KatsuhiroMorishita/Wireless-LED-control/circuit designed with Eagle/archive/readme.txt

注意事項をいかに示す。

１）本フォルダ内のファイルは最新版とは限りません。
２）回路パターンはCNC加工を前提に設計しています。
　そのままでは外部発注できません。
