KatsuhiroMorishita/Wireless-LED-control/program/type02/不採用となった電子回路モデル.pptx

## 電子回路モデル

2014-05-30
Katsuhiro MORISHITA

## 装置の概要図

キリ穴加工済みの竹筒　合計31本

石垣

ステージ奥の台

ステージ

## LEDの設置方法

断面

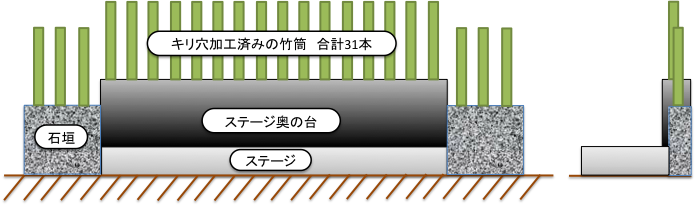
[picture p1: figure]

LANケーブル

## 制御のグルーピング

- 制御IOポートの削減
- 電源装置のスリム化
