KatsuhiroMorishita/Wireless-LED-control/circuit designed with Eagle/CNC加工条件/加工条件.png

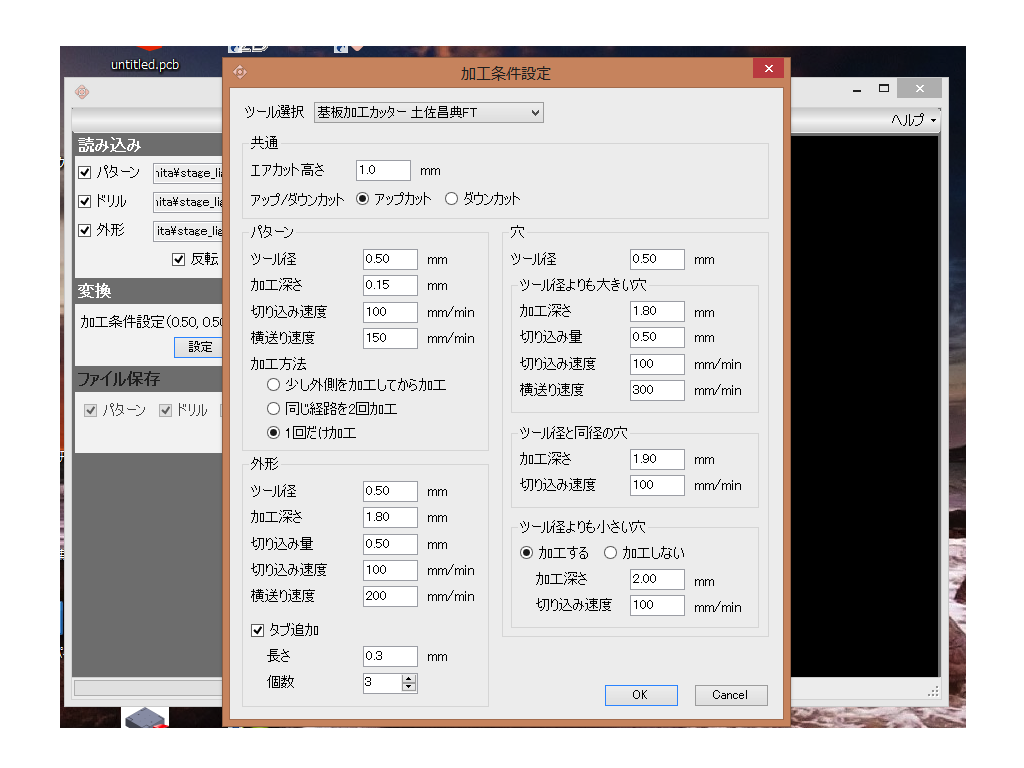
circuit designed with Eagle/CNC加工条件/加工条件.png
