KatsuhiroMorishita/Wireless-LED-control/program/type02/type02_firmware/利用可能なブートローダ.png

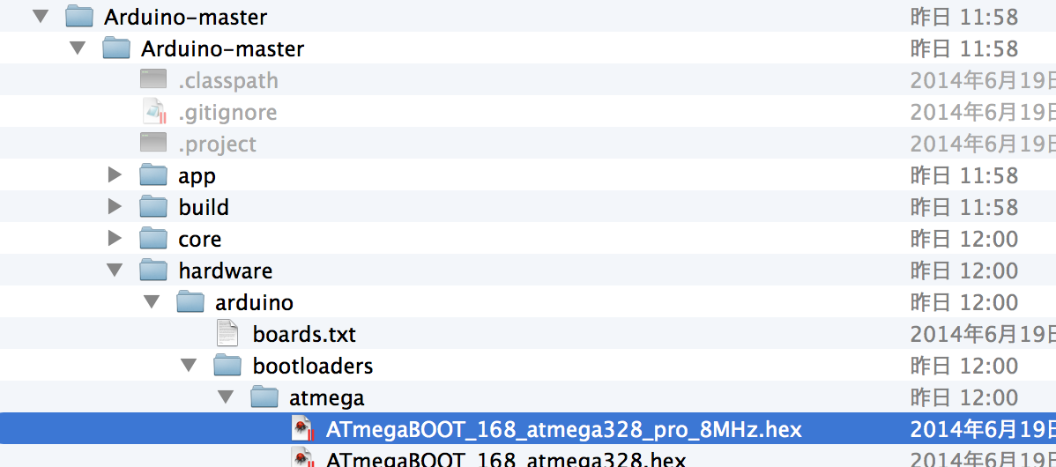
program/type02/type02_firmware/利用可能なブートローダ.png
