KatsuhiroMorishita/Wireless-LED-control/program/controler/order_switch/設計.pptx

Ch 0x0C

XBee
S1

XBee
S1

XBee
S1

Ch 0x14

XBee
S1

XBee
S1

XBee
S1

XBee
S1

XBee
S1

XBee
S1

XBee
S1

XBee
S1

XBee
S1

USBシリアル
最低、11200 kbps

XBee
S1

XBee
S1

Ch 0x0F

XBee
S1

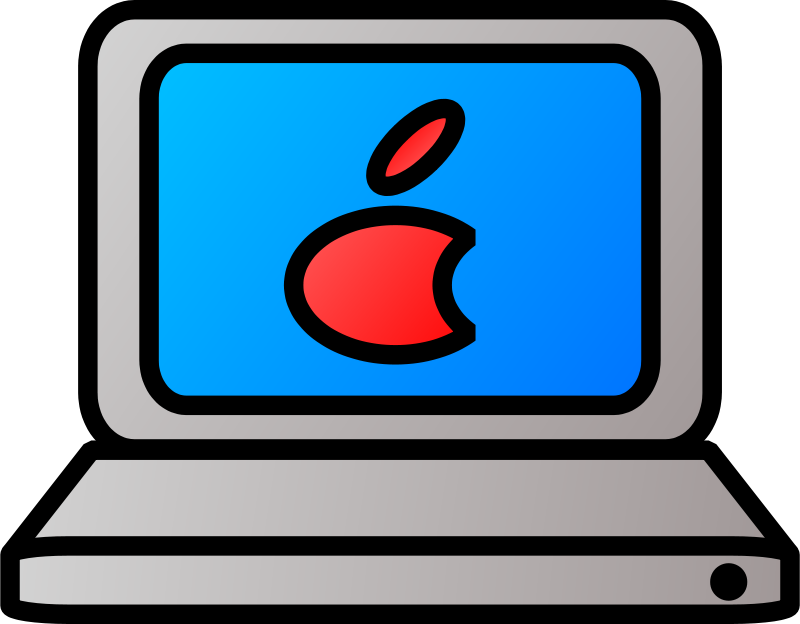
[picture p4: figure]
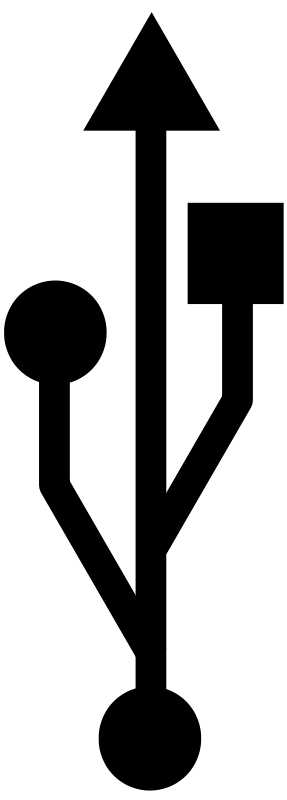
[picture p5: figure]
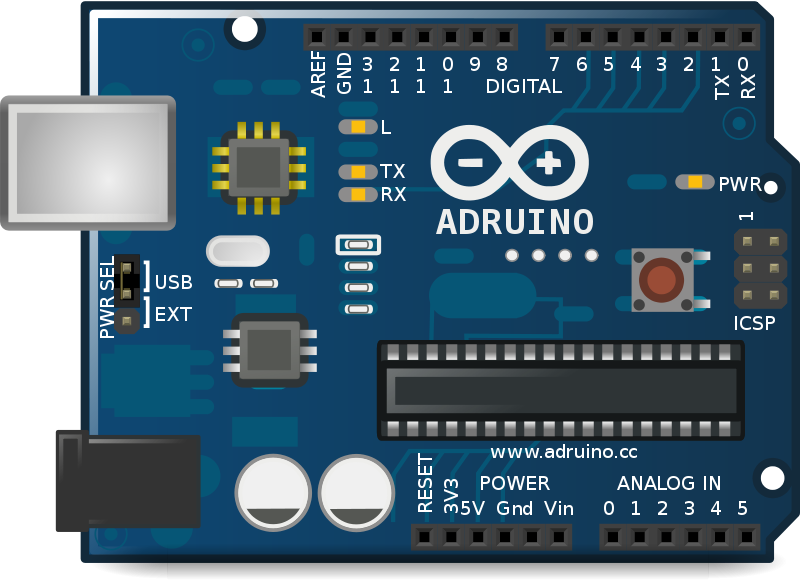
[picture p6: figure]

Arduino mega
（絵はUNO）

本スケッチの
実装対象

Arduino mega
（絵はUNO）
