KatsuhiroMorishita/Wireless-LED-control/program/type01/old/v1/test_data/test data.xlsx

Sheet: Sheet1
bias | 128
amplitude | 126
frequency [Hz] | 0.5
time step [s] | 0.1
 | red | green | blue
offset | 0 | 1.047197551 | 2.094395102
0 | 128 | 237 | 237
1 | 166 | 251 | 212
2 | 202 | 253 | 179
3 | 229 | 243 | 141
4 | 247 | 221 | 101
5 | 254 | 191 | 65
6 | 247 | 154 | 34
7 | 229 | 114 | 12
8 | 202 | 76 | 2
9 | 166 | 43 | 4
10 | 128 | 18 | 18
11 | 89 | 4 | 43
12 | 53 | 2 | 76
13 | 26 | 12 | 114
14 | 8 | 34 | 154
15 | 2 | 64 | 191
16 | 8 | 101 | 221
17 | 26 | 141 | 243
18 | 53 | 179 | 253
19 | 89 | 212 | 251
20 | 128 | 237 | 237
21 | 166 | 251 | 212
22 | 202 | 253 | 179
23 | 229 | 243 | 141
24 | 247 | 221 | 101
25 | 254 | 191 | 64
26 | 247 | 154 | 34
27 | 229 | 114 | 12
28 | 202 | 76 | 2
29 | 166 | 43 | 4
30 | 128 | 18 | 18
31 | 89 | 4 | 43
32 | 53 | 2 | 76
33 | 26 | 12 | 114
34 | 8 | 34 | 154
35 | 2 | 65 | 191
36 | 8 | 101 | 221
37 | 26 | 141 | 243
38 | 53 | 179 | 253
39 | 89 | 212 | 251
40 | 128 | 237 | 237
41 | 166 | 251 | 212
42 | 202 | 253 | 179
43 | 229 | 243 | 141
44 | 247 | 221 | 101
45 | 254 | 191 | 64
46 | 247 | 154 | 34
47 | 229 | 114 | 12
48 | 202 | 76 | 2
49 | 166 | 43 | 4
50 | 128 | 18 | 18
51 | 89 | 4 | 43
52 | 53 | 2 | 76
53 | 26 | 12 | 114
54 | 8 | 34 | 154
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
