KatsuhiroMorishita/Wireless-LED-control/circuit designed with Eagle/stage_light_control/stage_light_control.brd

## EAGLE design circuit designed with Eagle/stage_light_control/stage_light_control.brd (2014-06-23)

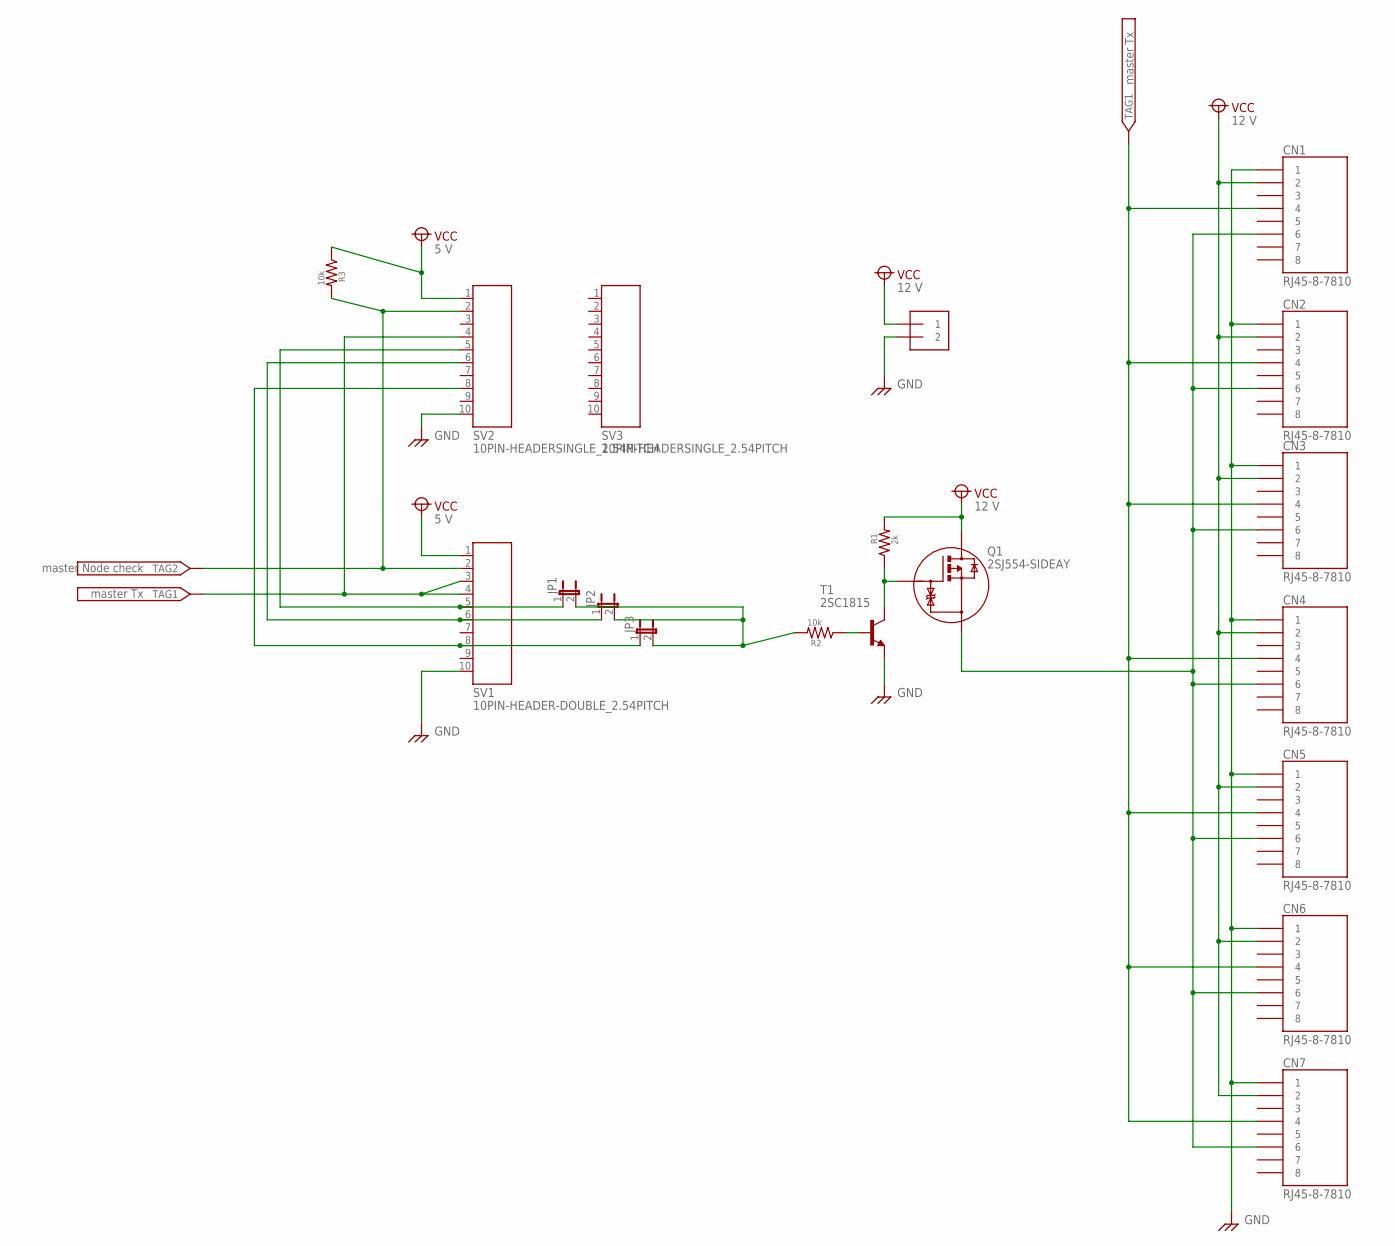
[picture p7: schematic stage_light_control.sch]

Parts:
CN1, CN2, CN3, CN4, CN5, CN6, CN7: RJ45-8-7810; RJ-45_7810-8P8C
J1: 1X2-7.5MM
JP1, JP2, JP3: JUMPER-2PTH; 1X02
Q1: 2SJ554-SIDEAY; TO-3P
R1: 2k; 1608(1.6*0.8MM)
R2, R3: 10k; 1608(1.6*0.8MM)
SV1: 10PIN-HEADER-DOUBLE_2.54PITCH; 2*5(2.54PITCH)
SV2, SV3: 10PIN-HEADERSINGLE_2.54PITCH; 1*10(2.54PITCH)
T1: 2SC1815; TO92-ECB

Connections:
GND: CN1.1, CN2.1, CN3.1, CN4.1, CN5.1, CN6.1, CN7.1, J1.P$2 (2), SV1.10, SV2.10, T1.E
unnamed: Q1.1, R1.P$3 (1), T1.C
unnamed: R2.P$3 (1), T1.B
unnamed: JP1.1, SV1.5, SV2.5
unnamed: JP2.1, SV1.6, SV2.6
unnamed: JP3.1, SV1.8, SV2.8
unnamed: CN1.6, CN2.6, CN3.6, CN4.6, CN5.6, CN6.6, CN7.6, Q1.2
unnamed: JP1.2, JP2.2, JP3.2, R2.P$4 (2)
TAG1: CN1.4, CN2.4, CN3.4, CN4.4, CN5.4, CN6.4, CN7.4, SV1.3, SV1.4, SV2.4
TAG2: R3.P$4 (2), SV1.2, SV2.2
VCC1: R3.P$3 (1), SV1.1, SV2.1
VCC2: CN1.2, CN2.2, CN3.2, CN4.2, CN5.2, CN6.2, CN7.2, J1.P$1 (1), Q1.3, R1.P$4 (2)

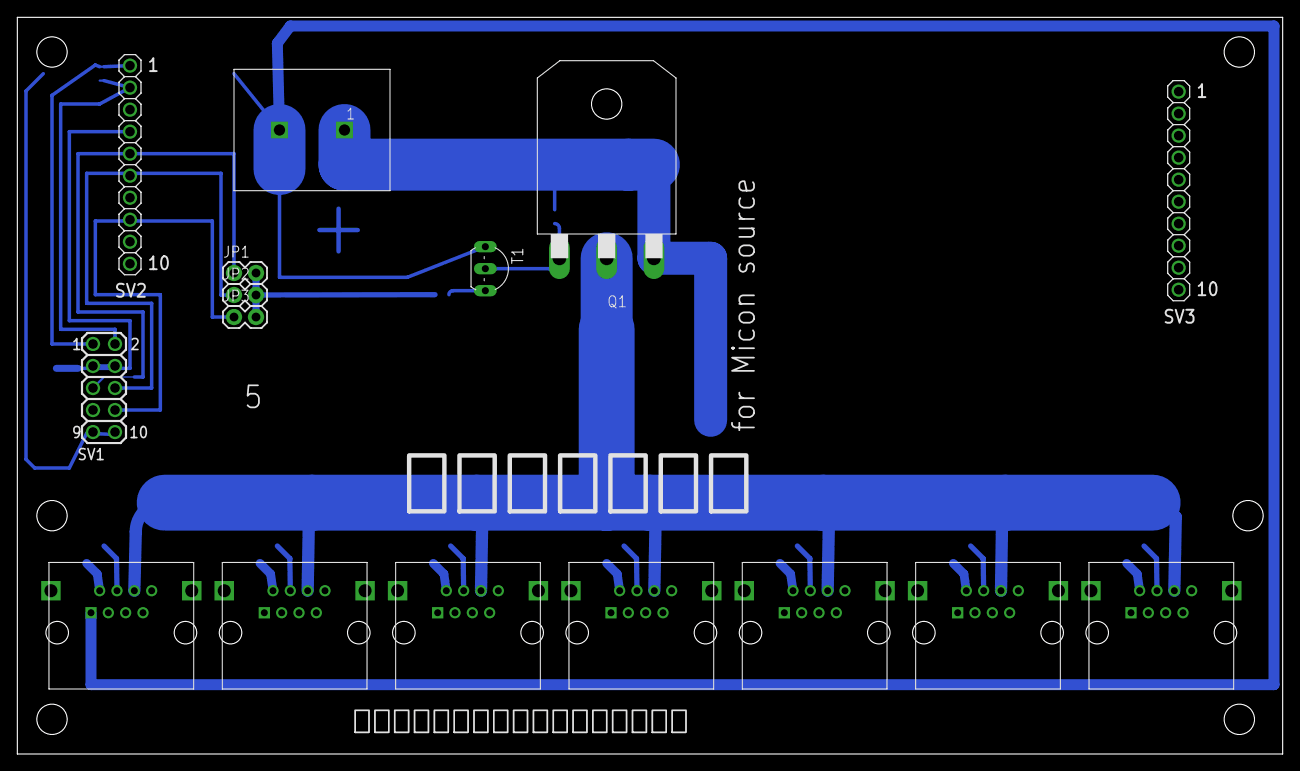
[picture p8: board stage_light_control.brd from above]

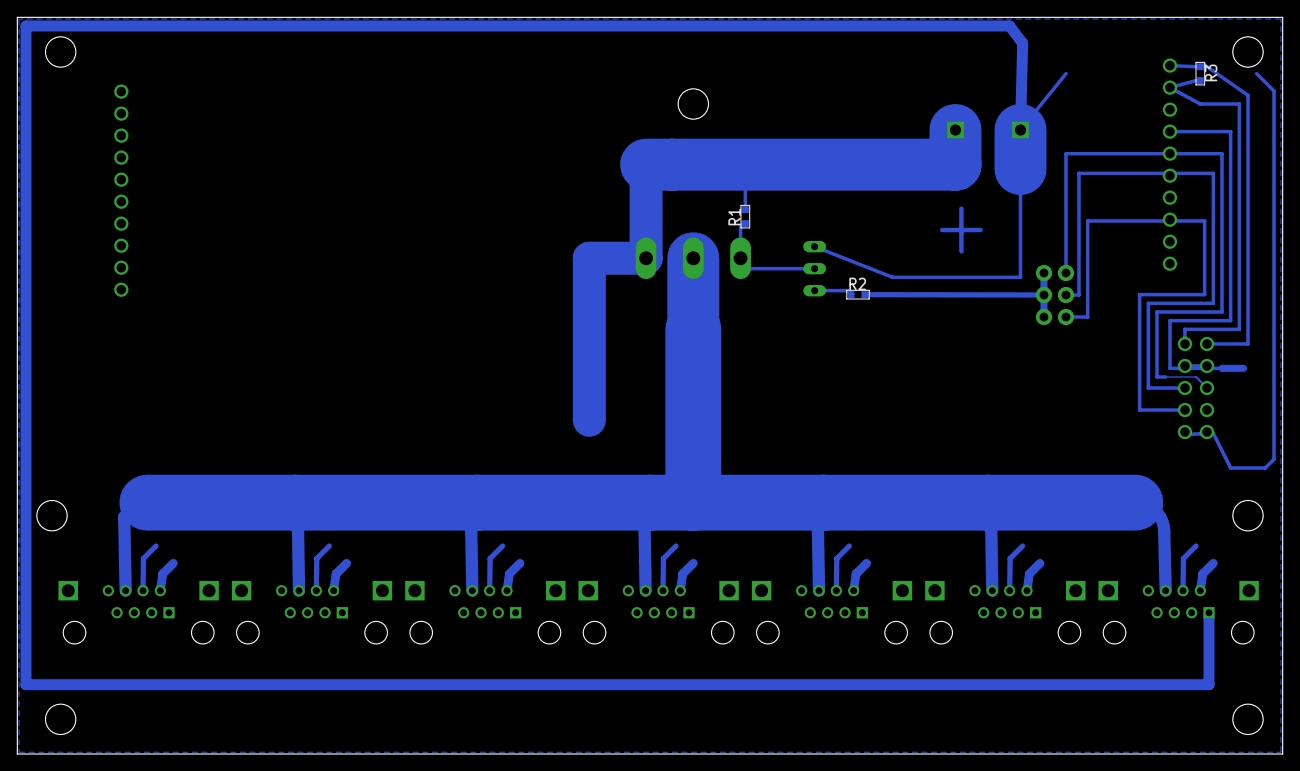
[picture p9: board stage_light_control.brd from below]

Board: 2 copper layers, 146.0 x 85.0 mm, 19 parts (3 on the bottom side), 12 nets.
