KatsuhiroMorishita/Wireless-LED-control/circuit designed with Eagle/take_light_table/table_light_shield.brd

## EAGLE design circuit designed with Eagle/take_light_table/table_light_shield.brd (2014-06-23)

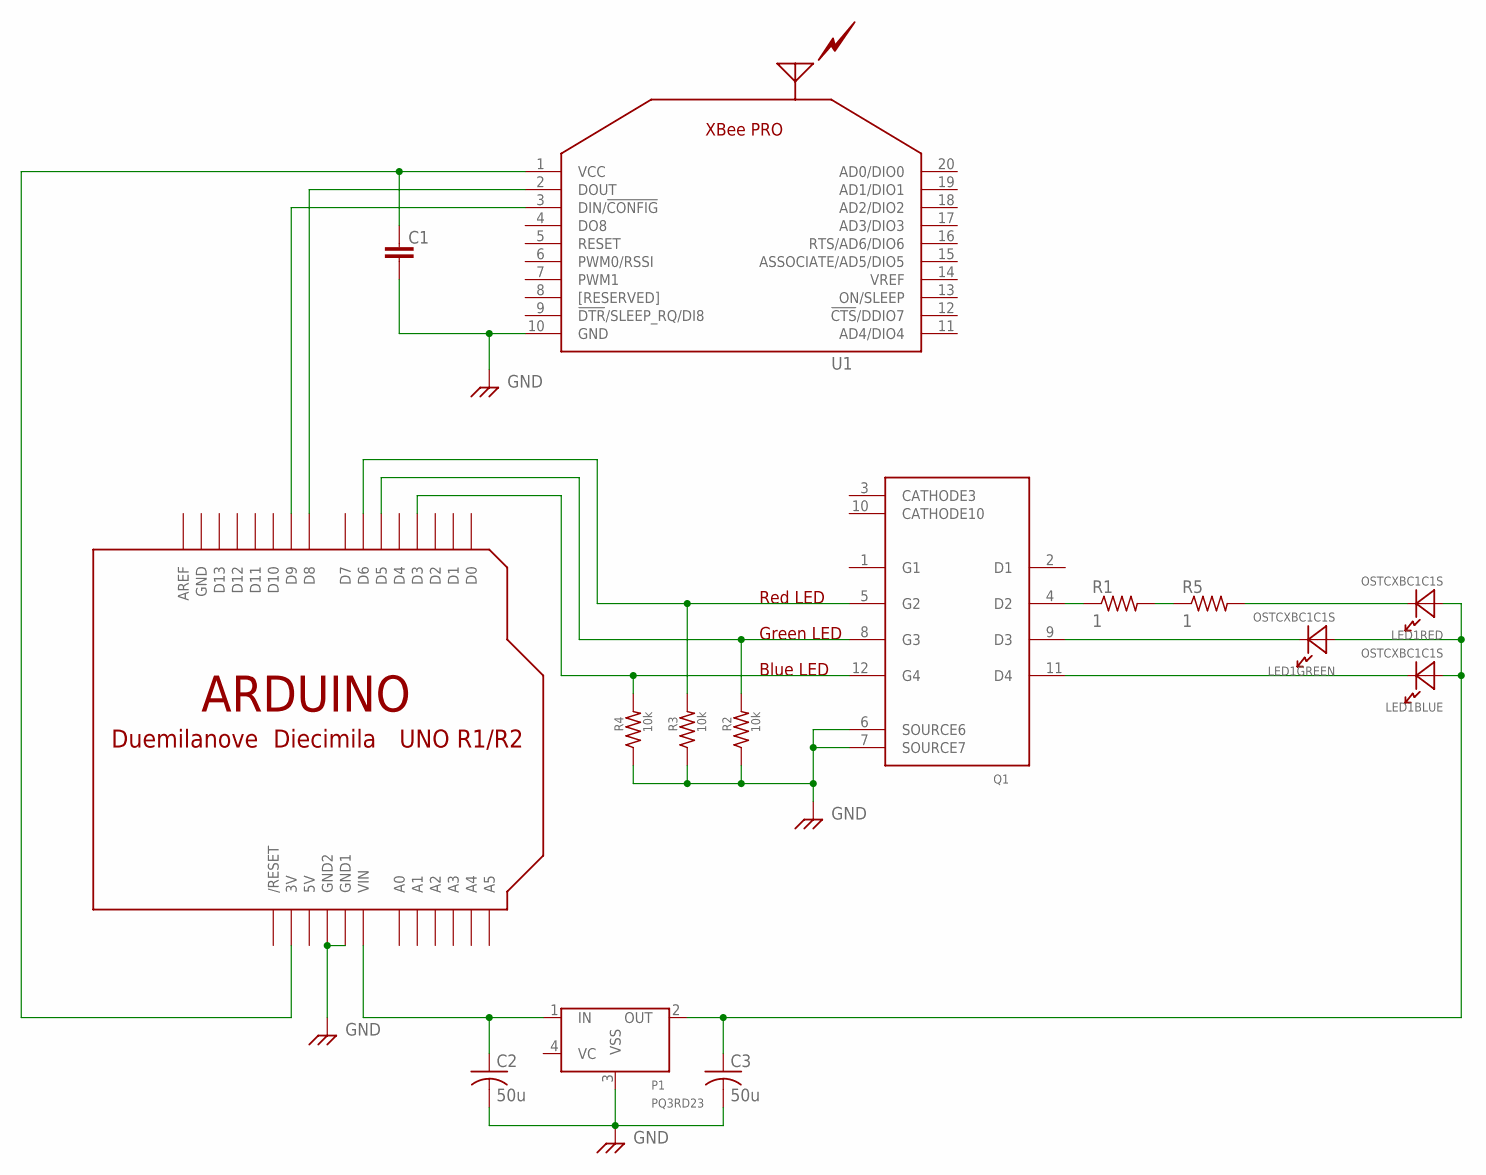
[picture p10: schematic table_light_shield.sch]

Parts:
C1: GRM18; 1608(1.6*0.8MM)
C2, C3: 50u; C025-050X050
LED1: OSTCXBC1C1S; OSTCXBC1C1S_WITH_HEATSINK
P1: PQ3RD23
Q1: MP4401
R1, R5: 1; 0805-THM
R2, R3, R4: 10k; 1608(1.6*0.8MM)
U1: XBEE_PROXPPN101BFCN; XBEE_ON_XPPN101BFCN-RC
U$1: ARDUINO-NOHOLE

Connections:
5V: U$1.5V
GND: C1.P$2 (2), C2.2, C3.2, P1.3 (VSS), Q1.6 (SOURCE6), Q1.7 (SOURCE7), R2.P$3 (1), R3.P$3 (1), R4.P$3 (1), U1.10 (GND), U$1.GND, U$1.GND1, U$1.GND2
unnamed: C2.1, P1.1 (IN), U$1.VIN
unnamed: Q1.4 (D2), R1.1
unnamed: Q1.5 (G2), R3.P$4 (2), U$1.D6
unnamed: Q1.8 (G3), R2.P$4 (2), U$1.D5
unnamed: Q1.12 (G4), R4.P$4 (2), U$1.D3
unnamed: C1.P$1 (1), U1.1 (VCC), U$1.3V
unnamed: U1.2 (DOUT), U$1.D8
unnamed: U1.3 (DIN/!CONFIG), U$1.D9
unnamed: LED1.B- (C), Q1.11 (D4)
unnamed: LED1.R- (C), R5.2
unnamed: R1.2, R5.1
unnamed: C3.1, LED1.B+ (A), LED1.G+ (A), LED1.R+ (A), P1.2 (OUT)
unnamed: LED1.G- (C), Q1.9 (D3)

Notes on the sheet:
Red LED
Green LED
Blue LED

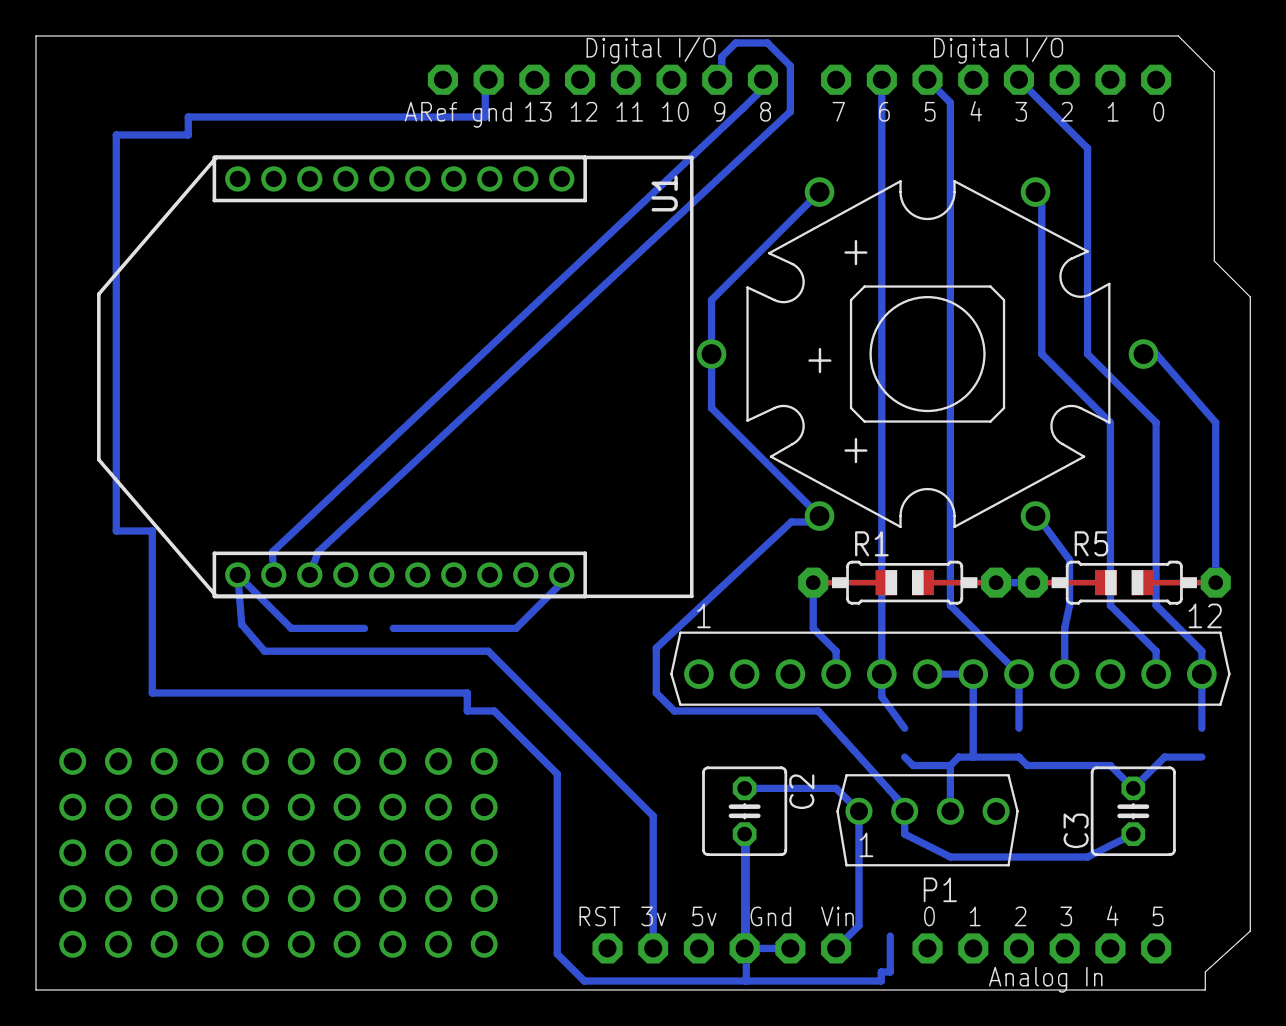
[picture p11: board table_light_shield.brd from above]

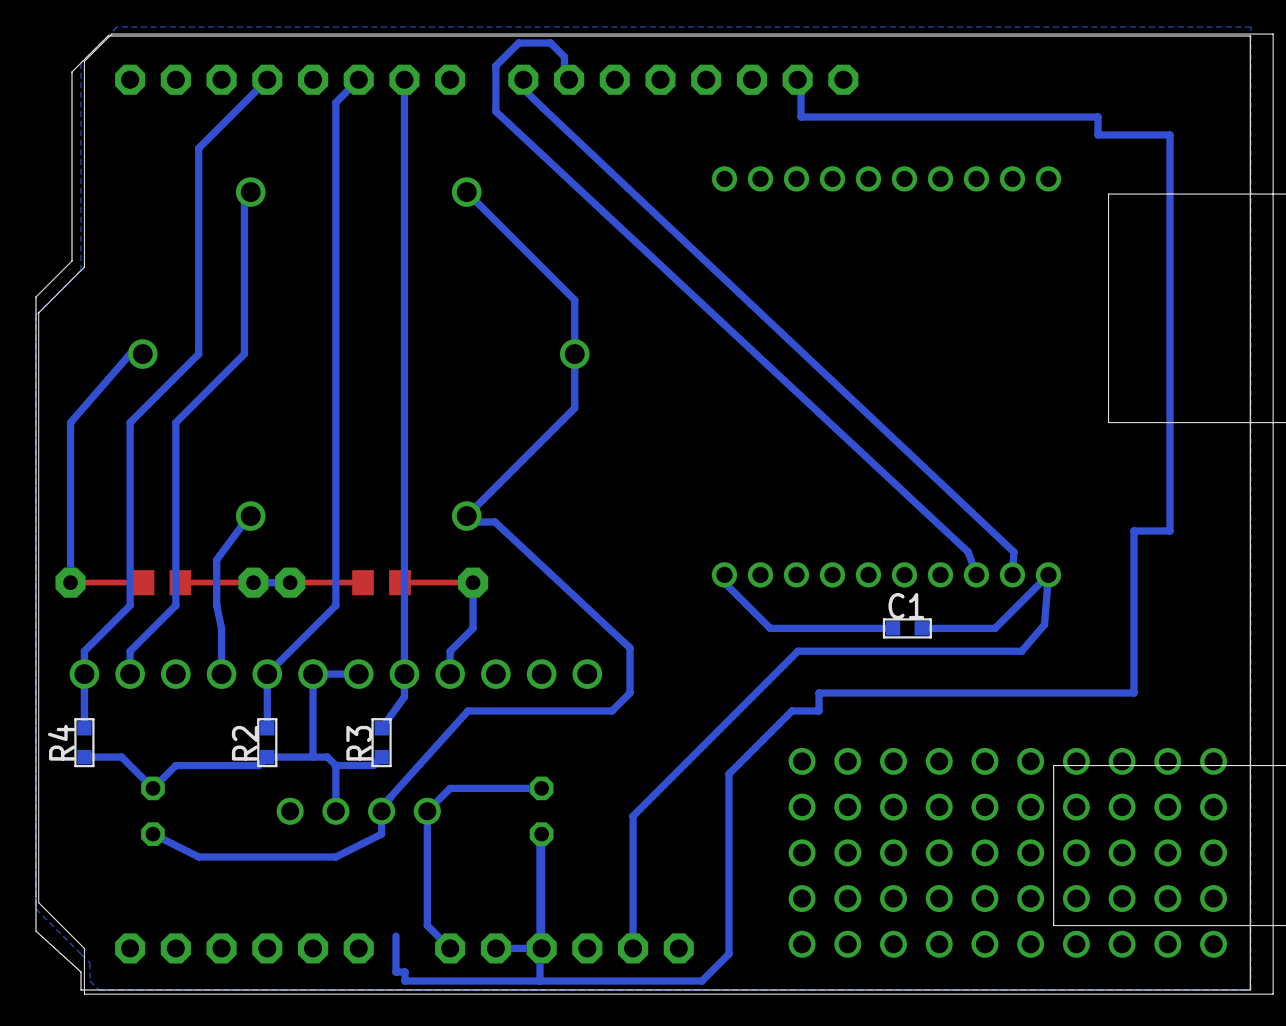
[picture p12: board table_light_shield.brd from below]

Board: 2 copper layers, 67.5 x 53.0 mm, 13 parts (4 on the bottom side), 14 nets.
