KatsuhiroMorishita/Wireless-LED-control/circuit designed with Eagle/stage_light/stage_light.brd

## EAGLE design circuit designed with Eagle/stage_light/stage_light.brd (2014-06-23)

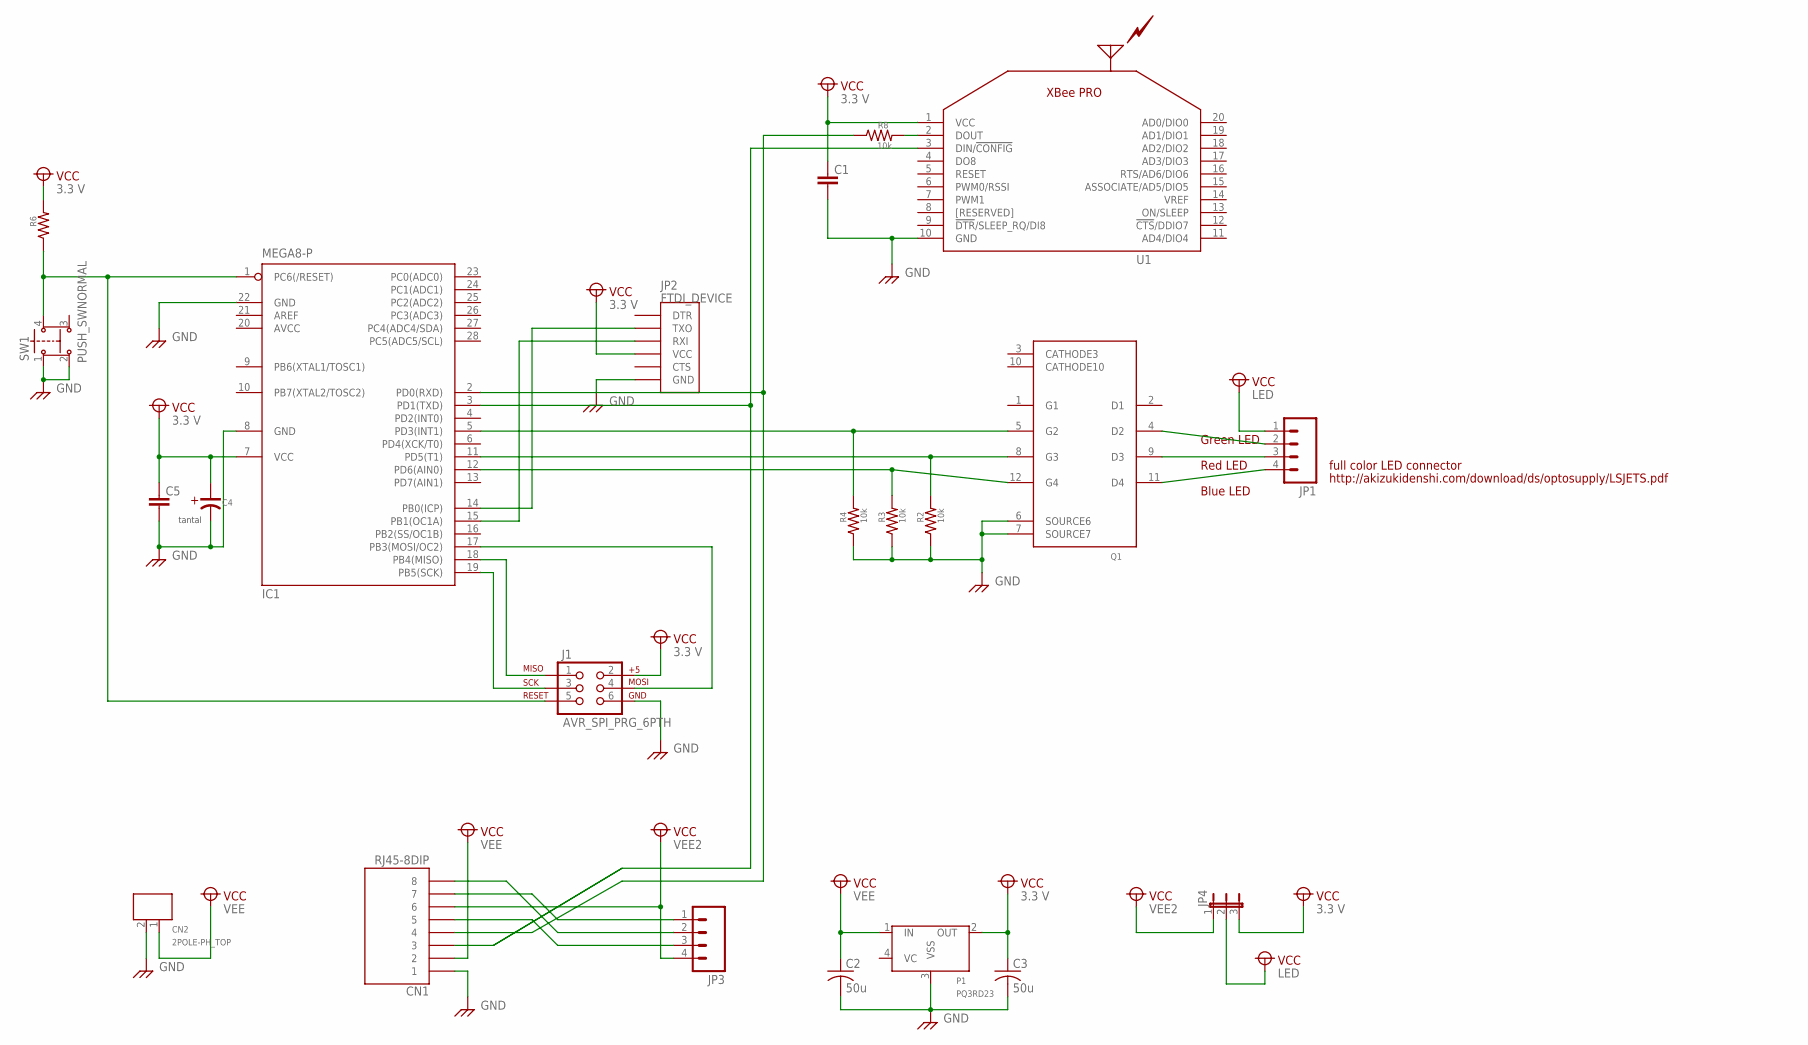
[picture p13: schematic stage_light.sch]

Parts:
C1, C5: GRM18; 1608(1.6*0.8MM)
C2, C3: 50u; C025-050X050
C4: CT-100U; 6134(6.1*3.4MM)_POLAR
CN1: RJ45-8DIP; AE-RJ-45-LAN-DIP-A
CN2: 2POLE-PH_TOP; B2B-PH-K-S(2MM_PITCH)
IC1: MEGA8-P; DIL28-3
J1: AVR_SPI_PRG_6PTH; 2X3
JP1: M04LONGPADS; 1X04_LONGPADS
JP2: FTDI_DEVICE; FTDI_DEVICE_SIDE
JP3: M04PTH; 1X04
JP4: JP2E; JP2
P1: PQ3RD23
Q1: MP4401
R2, R3, R4, R8: 10k; 1608(1.6*0.8MM)
R6: CHIP1608; 1608(1.6*0.8MM)
SW1: PUSH_SWNORMAL; PUSH_SW
U1: XBEE_PROXPPN101BFCN; XBEE_ON_XPPN101BFCN-RC

Connections:
AVCC: IC1.20 (AVCC)
GND: C1.P$2 (2), C2.2, C3.2, C4.-, C5.P$2 (2), CN1.1, CN2.2, IC1.8 (GND), IC1.22 (GND), J1.6, JP2.P$6 (GND), P1.3 (VSS), Q1.6 (SOURCE6), Q1.7 (SOURCE7), R2.P$3 (1), R3.P$3 (1), R4.P$3 (1), SW1.1, SW1.2, U1.10 (GND)
unnamed: JP1.3, Q1.9 (D3)
unnamed: JP1.2, Q1.4 (D2)
unnamed: IC1.12 (PD6(AIN0)), Q1.12 (G4), R3.P$4 (2)
unnamed: IC1.11 (PD5(T1)), Q1.8 (G3), R2.P$4 (2)
unnamed: IC1.5 (PD3(INT1)), Q1.5 (G2), R4.P$4 (2)
unnamed: JP1.4, Q1.11 (D4)
unnamed: IC1.14 (PB0(ICP)), JP2.P$2 (TXO)
unnamed: IC1.15 (PB1(OC1A)), JP2.P$3 (RXI)
unnamed: CN1.8, JP3.2
unnamed: CN1.5, JP3.3
unnamed: CN1.7, JP3.1
unnamed: IC1.1 (PC6(/RESET)), J1.5, R6.P$3 (1), SW1.4 (P3)
unnamed: R8.P$4 (2), U1.2 (DOUT)
unnamed: CN1.4, IC1.2 (PD0(RXD)), R8.P$3 (1)
unnamed: CN1.3, IC1.3 (PD1(TXD)), U1.3 (DIN/!CONFIG)
unnamed: IC1.18 (PB4(MISO)), J1.1
unnamed: IC1.19 (PB5(SCK)), J1.3
unnamed: IC1.17 (PB3(MOSI/OC2)), J1.4
VCC1: C2.1, CN1.2, CN2.1, P1.1 (IN)
VCC2: C1.P$1 (1), C3.1, C4.+, C5.P$1 (1), IC1.7 (VCC), J1.2, JP2.P$4 (VCC), JP4.3, P1.2 (OUT), R6.P$4 (2), U1.1 (VCC)
VCC3: JP1.1, JP4.2
VCC4: CN1.6, JP3.4, JP4.1

Notes on the sheet:
Red LED
Green LED
Blue LED
full color LED connector
http://akizukidenshi.com/download/ds/optosupply/LSJETS.pdf

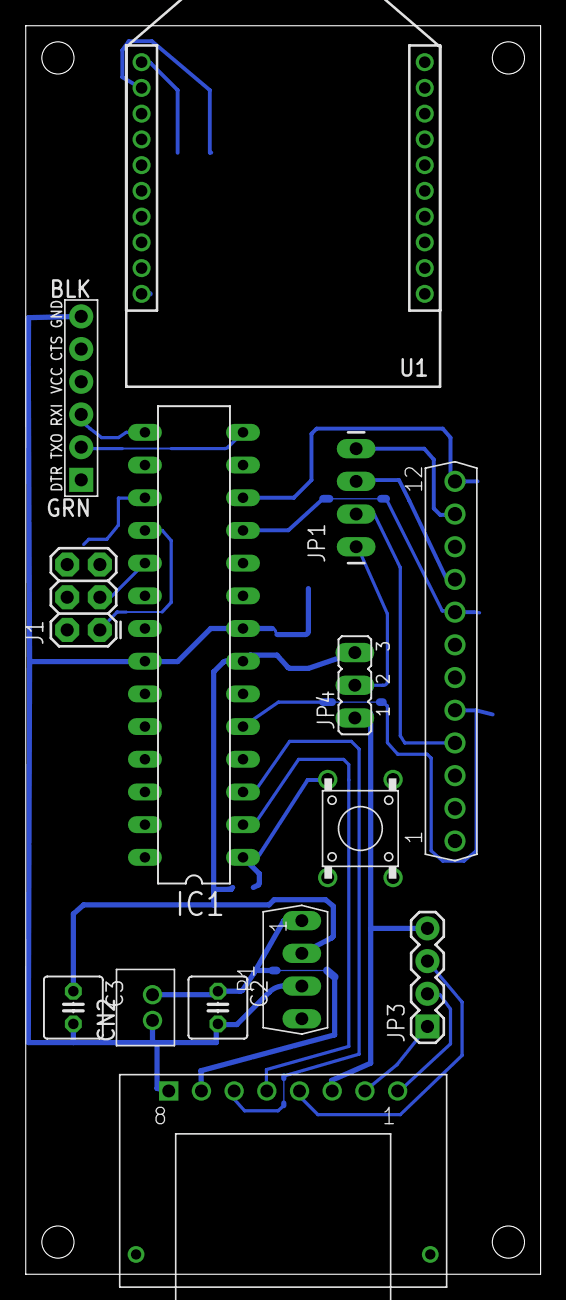
[picture p14: board stage_light.brd from above]

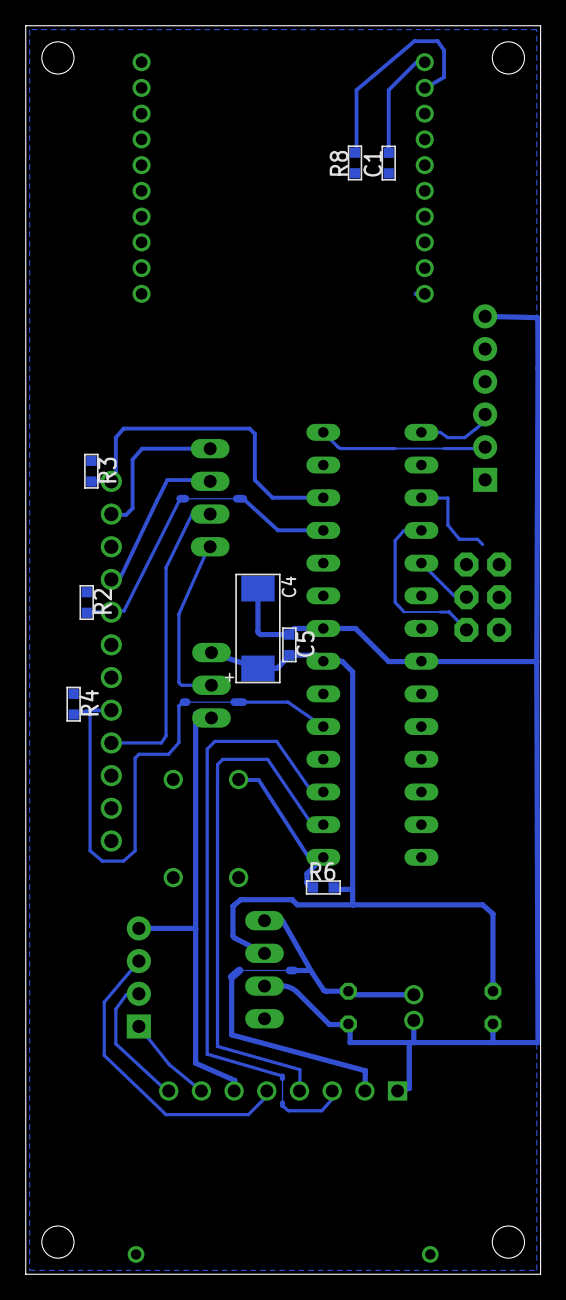
[picture p15: board stage_light.brd from below]

Board: 2 copper layers, 40.0 x 97.0 mm, 22 parts (8 on the bottom side), 23 nets.
