KatsuhiroMorishita/Wireless-LED-control/circuit designed with Eagle/stage_light_paste/stage_light_paste.brd

## EAGLE design circuit designed with Eagle/stage_light_paste/stage_light_paste.brd (2014-06-23)

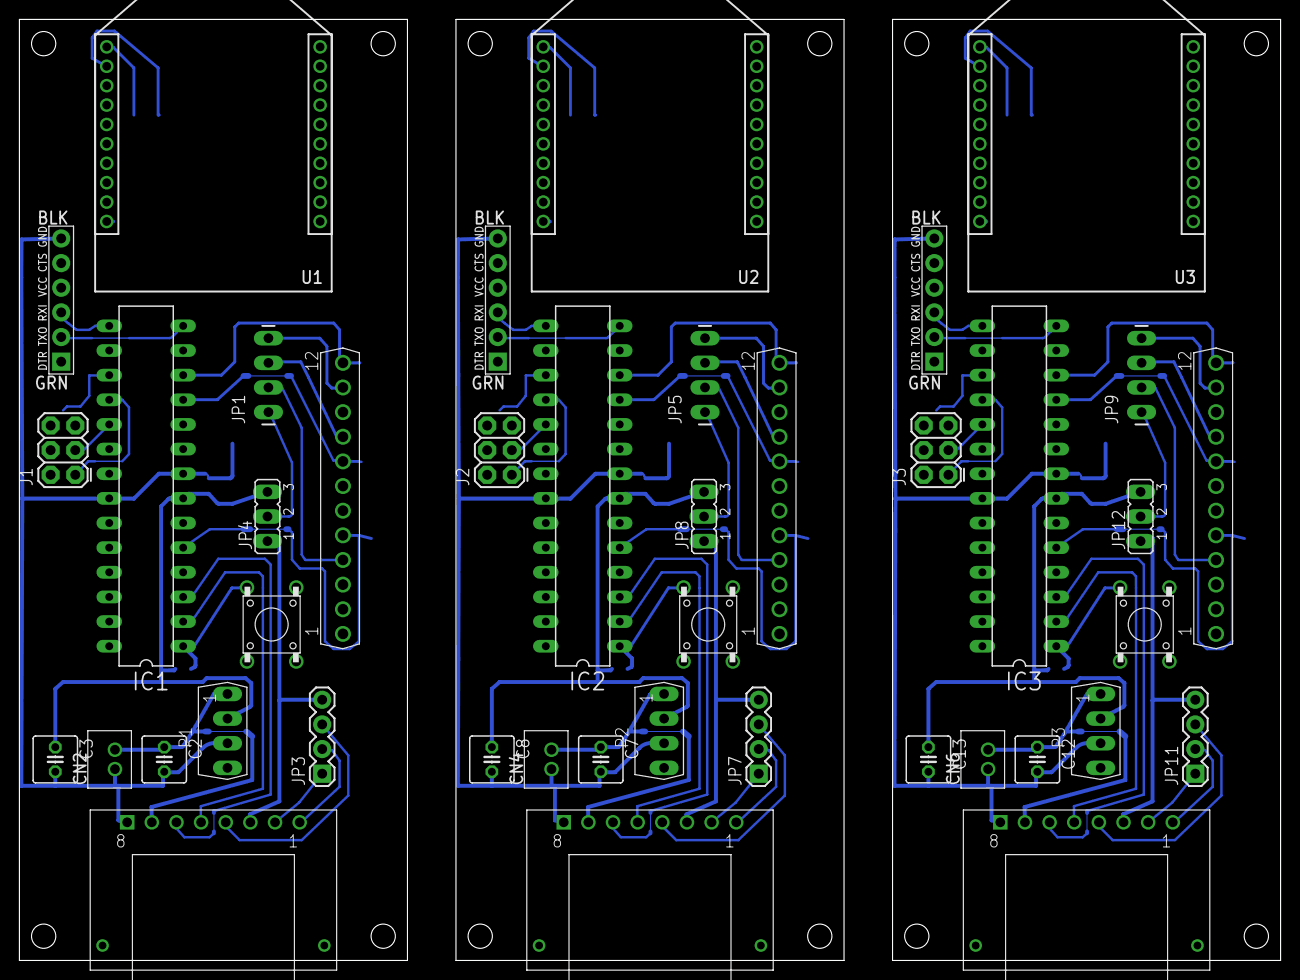
[picture p16: board stage_light_paste.brd from above]

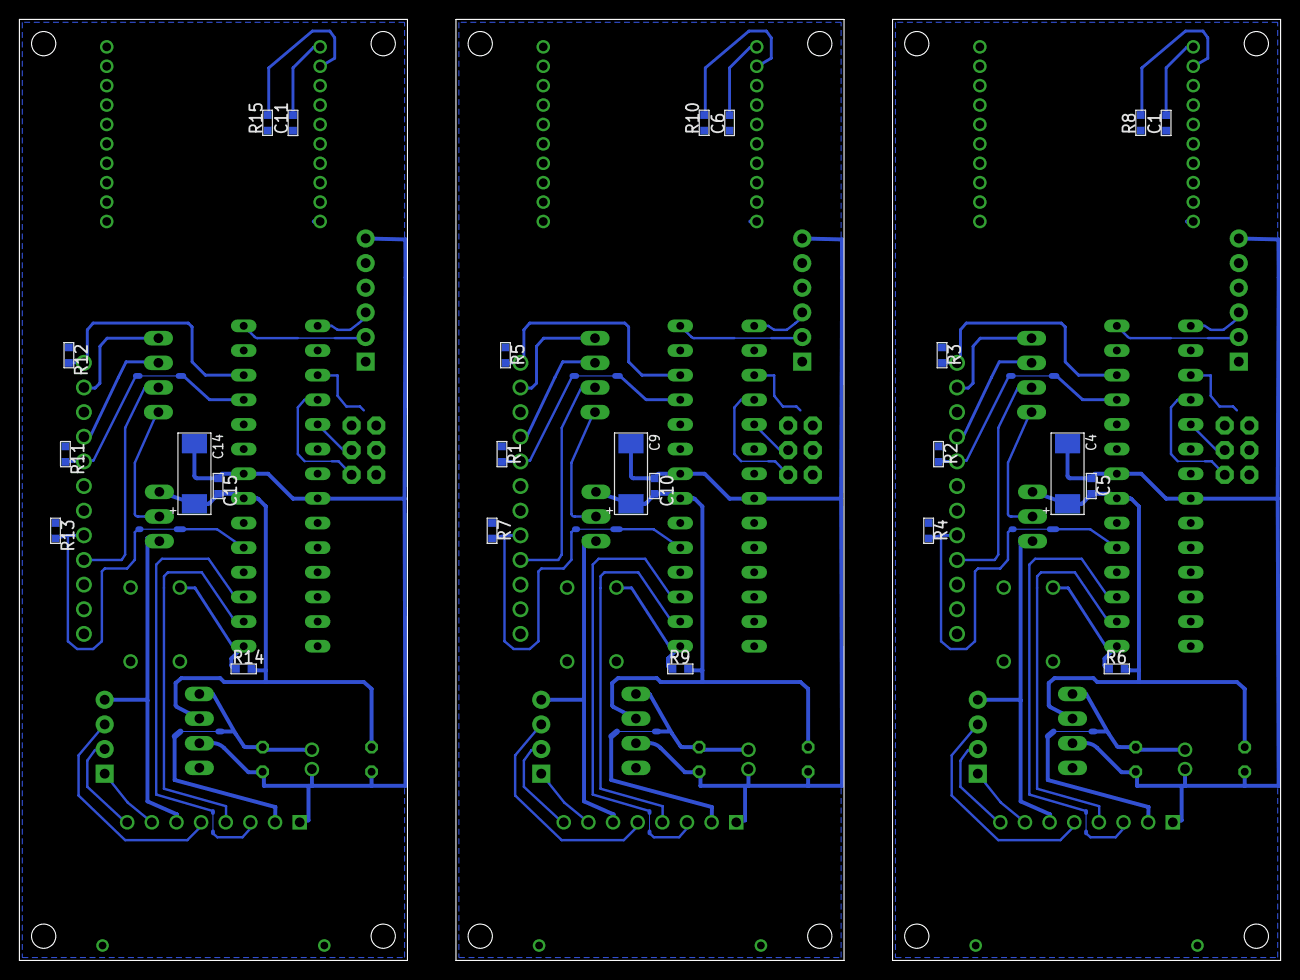
[picture p17: board stage_light_paste.brd from below]

Board: 2 copper layers, 130.0 x 97.0 mm, 66 parts (24 on the bottom side), 69 nets.

Parts:
C1, C5, C6, C10, C11, C15: 1608(1.6*0.8MM)
C2, C3, C7, C8, C12, C13: 50u; C025-050X050
C4, C9, C14: 6134(6.1*3.4MM)_POLAR
CN1, CN3, CN5: RJ45-8DIP; AE-RJ-45-LAN-DIP-A
CN2, CN4, CN6: 2POLE-PH_TOP; B2B-PH-K-S(2MM_PITCH)
IC1, IC2, IC3: MEGA8-P; DIL28-3
J1, J2, J3: AVR_SPI_PRG_6PTH; 2X3
JP1, JP5, JP9: 1X04_LONGPADS
JP2, JP6, JP10: FTDI_DEVICE; FTDI_DEVICE_SIDE
JP3, JP7, JP11: 1X04
JP4, JP8, JP12: JP2
P1, P2, P3: PQ3RD23
Q1, Q2, Q3: MP4401
R1, R2, R3, R4, R5, R7, R8, R10, R11, R12, R13, R15: 10k; 1608(1.6*0.8MM)
R6, R9, R14: 1608(1.6*0.8MM)
SW1, SW2, SW3: PUSH_SWNORMAL; PUSH_SW
U1, U2, U3: XBEE_PROXPPN101BFCN; XBEE_ON_XPPN101BFCN-RC

Connections:
GND: C1.P$2, C2.2, C3.2, C4.-, C5.P$2, CN1.1, CN2.2, IC1.8, IC1.22, J1.6, JP2.P$6, P1.3, Q1.6, Q1.7, R2.P$3, R3.P$3, R4.P$3, SW1.1, SW1.2, U1.10
GND1: C6.P$2, C7.2, C8.2, C9.-, C10.P$2, CN3.1, CN4.2, IC2.8, IC2.22, J2.6, JP6.P$6, P2.3, Q2.6, Q2.7, R1.P$3, R5.P$3, R7.P$3, SW2.1, SW2.2, U2.10
GND2: C11.P$2, C12.2, C13.2, C14.-, C15.P$2, CN5.1, CN6.2, IC3.8, IC3.22, J3.6, JP10.P$6, P3.3, Q3.6, Q3.7, R11.P$3, R12.P$3, R13.P$3, SW3.1, SW3.2, U3.10
unnamed: JP1.3, Q1.9
unnamed: JP1.2, Q1.4
unnamed: IC1.12, Q1.12, R3.P$4
unnamed: IC1.11, Q1.8, R2.P$4
unnamed: IC1.5, Q1.5, R4.P$4
unnamed: JP1.4, Q1.11
unnamed: IC1.14, JP2.P$2
unnamed: IC1.15, JP2.P$3
unnamed: CN1.8, JP3.2
unnamed: CN1.5, JP3.3
unnamed: CN1.7, JP3.1
unnamed: IC1.1, J1.5, R6.P$3, SW1.4
unnamed: R8.P$4, U1.2
unnamed: IC2.12, Q2.12, R5.P$4
unnamed: CN1.4, IC1.2, R8.P$3
unnamed: CN1.3, IC1.3, U1.3
unnamed: IC2.11, Q2.8, R1.P$4
unnamed: IC1.18, J1.1
unnamed: IC1.19, J1.3
unnamed: IC1.17, J1.4
unnamed: IC2.5, Q2.5, R7.P$4
unnamed: IC2.1, J2.5, R9.P$3, SW2.4
unnamed: CN3.4, IC2.2, R10.P$3
unnamed: CN3.3, IC2.3, U2.3
unnamed: IC2.18, J2.1
unnamed: IC2.19, J2.3
unnamed: IC2.17, J2.4
unnamed: JP5.3, Q2.9
unnamed: JP5.2, Q2.4
unnamed: JP5.4, Q2.11
unnamed: IC2.14, JP6.P$2
unnamed: IC2.15, JP6.P$3
unnamed: CN3.8, JP7.2
unnamed: CN3.5, JP7.3
unnamed: CN3.7, JP7.1
unnamed: R10.P$4, U2.2
unnamed: IC3.12, Q3.12, R12.P$4
unnamed: IC3.11, Q3.8, R11.P$4
unnamed: IC3.5, Q3.5, R13.P$4
unnamed: IC3.1, J3.5, R14.P$3, SW3.4
unnamed: CN5.4, IC3.2, R15.P$3
unnamed: CN5.3, IC3.3, U3.3
unnamed: IC3.18, J3.1
unnamed: IC3.19, J3.3
unnamed: IC3.17, J3.4
unnamed: JP9.3, Q3.9
unnamed: JP9.2, Q3.4
unnamed: JP9.4, Q3.11
unnamed: IC3.14, JP10.P$2
unnamed: IC3.15, JP10.P$3
unnamed: CN5.8, JP11.2
unnamed: CN5.5, JP11.3
unnamed: CN5.7, JP11.1
unnamed: R15.P$4, U3.2
VCC1: C2.1, CN1.2, CN2.1, P1.1
VCC2: C1.P$1, C3.1, C4.+, C5.P$1, IC1.7, J1.2, JP2.P$4, JP4.3, P1.2, R6.P$4, U1.1
VCC3: JP1.1, JP4.2
VCC4: CN1.6, JP3.4, JP4.1
VCC5: C6.P$1, C8.1, C9.+, C10.P$1, IC2.7, J2.2, JP6.P$4, JP8.3, P2.2, R9.P$4, U2.1
VCC6: C7.1, CN3.2, CN4.1, P2.1
VCC7: JP5.1, JP8.2
VCC8: CN3.6, JP7.4, JP8.1
VCC9: C11.P$1, C13.1, C14.+, C15.P$1, IC3.7, J3.2, JP10.P$4, JP12.3, P3.2, R14.P$4, U3.1
VCC10: C12.1, CN5.2, CN6.1, P3.1
VCC11: JP9.1, JP12.2
VCC12: CN5.6, JP11.4, JP12.1
