KatsuhiroMorishita/Wireless-LED-control/circuit designed with Eagle/take_light_table2_paste/multi_paste.brd

## EAGLE design circuit designed with Eagle/take_light_table2_paste/multi_paste.brd (2014-06-23)

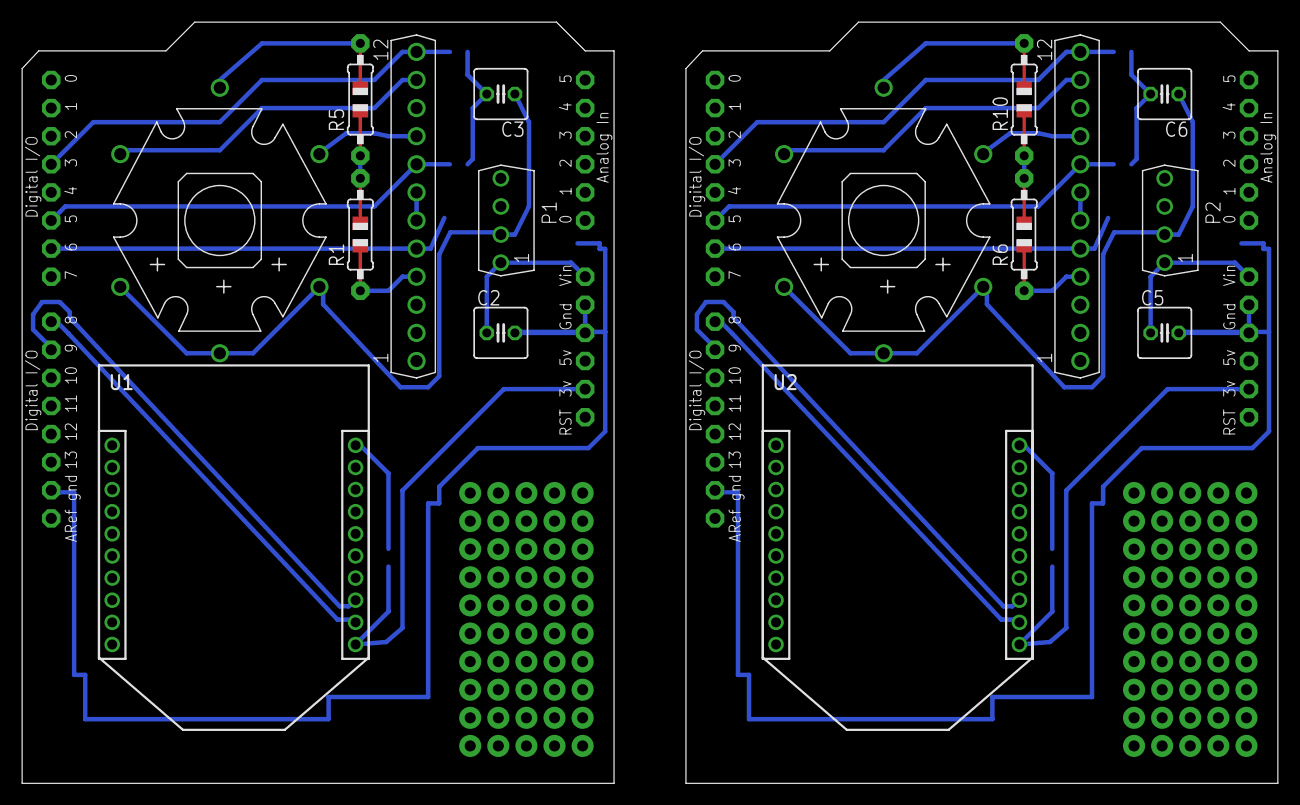
[picture p18: board multi_paste.brd from above]

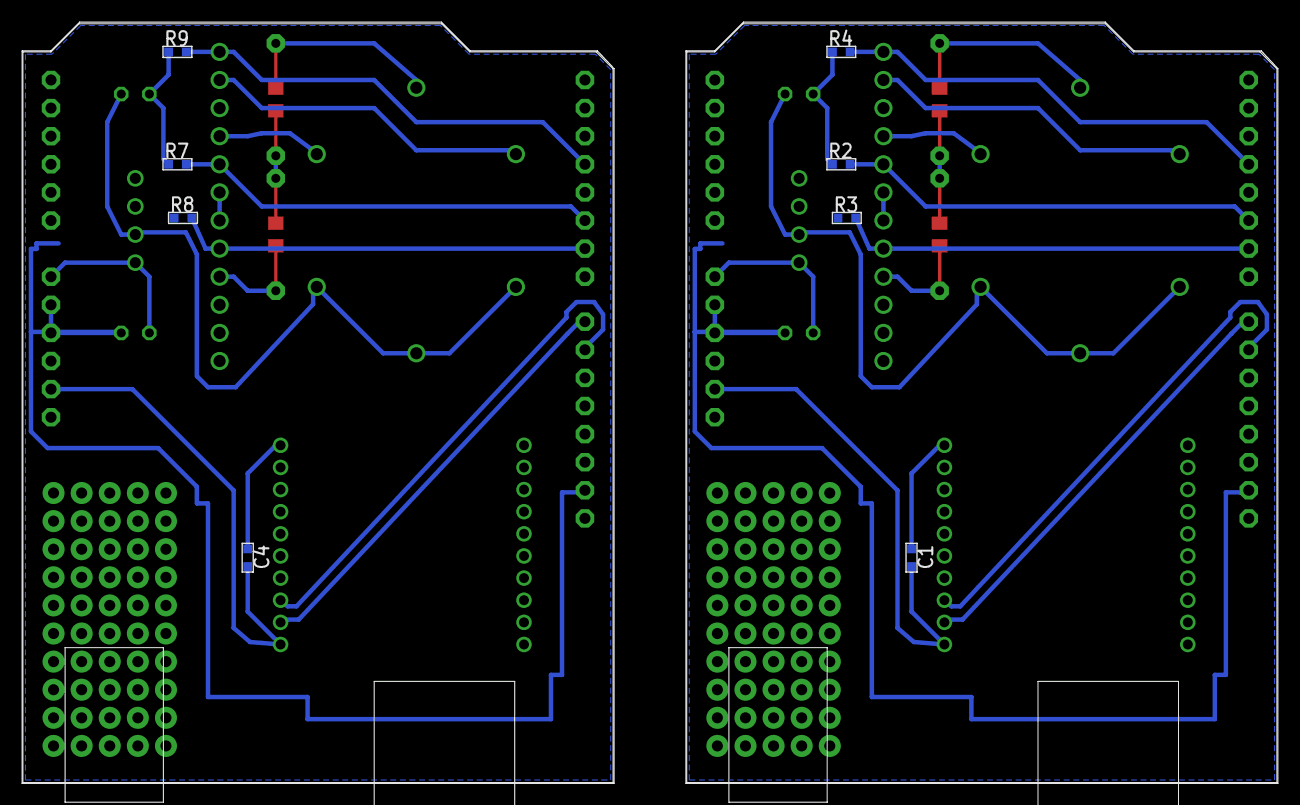
[picture p19: board multi_paste.brd from below]

Board: 2 copper layers, 113.5 x 68.8 mm, 26 parts (8 on the bottom side), 28 nets.

Parts:
C1, C4: 1608(1.6*0.8MM)
C2, C3, C5, C6: 50u; C025-050X050
LED1, LED2: OSTCXBC1C1S; OSTCXBC1C1S_WITH_HEATSINK
P1, P2: PQ3RD23
Q1, Q2: MP4401
R1, R5, R6, R10: 1; 0805-THM
R2, R3, R4, R7, R8, R9: 10k; 1608(1.6*0.8MM)
U1, U2: XBEE_PROXPPN101BFCN; XBEE_ON_XPPN101BFCN-RC
U$1, U$2: ARDUINO-NOHOLE

Connections:
GND: C1.P$2, C2.2, C3.2, P1.3, Q1.6, Q1.7, R2.P$3, R3.P$3, R4.P$3, U1.10, U$1.GND, U$1.GND1, U$1.GND2
GND1: C4.P$2, C5.2, C6.2, P2.3, Q2.6, Q2.7, R7.P$3, R8.P$3, R9.P$3, U2.10, U$2.GND, U$2.GND1, U$2.GND2
unnamed: C2.1, P1.1, U$1.VIN
unnamed: Q1.4, R1.1
unnamed: Q1.5, R3.P$4, U$1.D6
unnamed: Q1.8, R2.P$4, U$1.D5
unnamed: Q1.12, R4.P$4, U$1.D3
unnamed: C1.P$1, U1.1, U$1.3V
unnamed: U1.2, U$1.D8
unnamed: U1.3, U$1.D9
unnamed: LED1.B-, Q1.11
unnamed: LED1.R-, R5.2
unnamed: R1.2, R5.1
unnamed: C3.1, LED1.B+, LED1.G+, LED1.R+, P1.2
unnamed: LED1.G-, Q1.9
unnamed: C5.1, P2.1, U$2.VIN
unnamed: Q2.4, R6.1
unnamed: Q2.5, R8.P$4, U$2.D6
unnamed: Q2.8, R7.P$4, U$2.D5
unnamed: Q2.12, R9.P$4, U$2.D3
unnamed: C4.P$1, U2.1, U$2.3V
unnamed: U2.2, U$2.D8
unnamed: U2.3, U$2.D9
unnamed: LED2.B-, Q2.11
unnamed: LED2.R-, R10.2
unnamed: C6.1, LED2.B+, LED2.G+, LED2.R+, P2.2
unnamed: LED2.G-, Q2.9
unnamed: R6.2, R10.1
