KatsuhiroMorishita/Wireless-LED-control/program/processing_codes/header2_keyboard/header2_keyboard.pde

/* program name: header2_keyboard                       */
/* author:  Katsuhiro Morishita                         */
/* purpose: to control with key press.                  */
/* plat form: Processing 2.2.1                          */
/* create:  2014-06-06                                  */
/* license:  MIT                                        */
/* format: header code, red, green, module index        */
import processing.serial.*;

// target
final int module_id_start = 101;
final int module_id_end = 121;

// com
Serial myPort;
final int baudrate = 19200;

// header
final byte header_v2 = 0x3f;
final byte header_v3 = 0x4f;
final byte header_v4 = 0x5f;
final byte header_v5 = 0x6f;

// LED
float[] coefficient = {0.8, 1.0, 0.8};
float power = 1.0;
//-------------------------------

// send light pattern
void light(int r, int g, int b, int unit_id)
{
  // send header
  myPort.write(header_v2);
  delay(5);
  
  // tuning
  r = (int)((float)r * coefficient[0] * power);
  g = (int)((float)g * coefficient[1] * power);
  b = (int)((float)b * coefficient[2] * power);
  
  // send RGB pattern
  int limit = 127;
  if(r > limit)
    r = limit;
  if(r < 0)
    r = 0;
  myPort.write(r | 0x80);
  if(g > limit)
    g = limit;
  if(g < 0)
    g = 0;
  myPort.write(g | 0x80);
  if(b > limit)
    b = limit;
  if(b < 0)
    b = 0;
  myPort.write(b | 0x80);
  
  // send id
  myPort.write(unit_id | 0x80);
  print("ID: ");
  println(str(unit_id));
  
  // show ID for Front
  text("hoge", 0, 0, 300, 300);

  return;
}


void pattern01()
{
  float omega = 0.05;
  float pi = 3.141592;
  float t = (float)millis() / 1000.0;
  float theta = 2.0 * pi * omega * t;
  int range = 100 / 2;
  float offset = 120.0 / 180.0 * pi;
  int r = (int)(sin(theta + offset * 0) * range + range);
  int g = (int)(sin(theta + offset * 1) * range + range);
  int b = (int)(sin(theta + offset * 2) * range + range);
  background(r, g, b);
  for(int _id = module_id_start; _id <= module_id_end; _id++)
  {
    light(r, g, b, _id);
    /*
    for(int i = 0; i <= 1; i++)
    {
      int k = _id + i * 5;
      if(k > module_id_end) k = module_id_start + k - module_id_end;
      if(k < module_id_start) k = module_id_end + k - module_id_start;
      light(r, g, b, k);
    }
    */
  }
}

void pattern02()
{
  float omega = 0.05;
  float pi = 3.141592;
  float t = (float)millis() / 1000.0;
  float theta = 2.0 * pi * omega * t;
  int range = 100 / 2;
  float offset = 120.0 / 180.0 * pi;
  int r = (int)(sin(theta + offset * 0) * range + range);
  int g = (int)(sin(theta + offset * 1) * range + range);
  int b = (int)(sin(theta + offset * 2) * range + range);
  background(r, g, b);
  for(int _id = module_id_start; _id <= module_id_end; _id++){
    light(r, g, b, _id);
    delay(100);
    light(0, 0, 0, _id);
  }
}


void setup() 
{
  // window size
  size(400, 400);
  frameRate(20);
  textSize(40);
  fill(0);
  
  // serial port setting
  String[] ports = Serial.list();
  println(ports);
  String port = "COM18";      // for Windows
  /**/
  for (int i = 0 ; i < ports.length; i++)
  {
    port = ports[i];
    if(match(port, ".*usbserial.*") != null)
      break;
  }
  /**/
  myPort = new Serial(this, port, baudrate);
  
  // test light pattern
  for(int _id = module_id_start; _id <= module_id_end; _id++)
    light(255, 255, 255, _id);
  delay(2000);
  for(int _id = module_id_start; _id <= module_id_end; _id++)
    light(0, 0, 0, _id);
}

void draw()
{
  pattern01();
}

void serialEvent(Serial myPort) 
{
  String msg = myPort.readStringUntil('\n');
  //text(msg, 50, 50);
  //String msg = myPort.readString();
  if(msg != null)
    println(trim(msg));
}

// keyboard event
// send light pattern to LED control module.
void keyPressed()
{
  int i = (key - 0x30);
  print("key: ");
  println(i);
  
  float pi = 3.14;
  float theta = i / 9.0 * 2.0 * pi;
  int range = 127 / 2;
  float offset = 120.0 / 180.0 * pi;
  int r = (int)(sin(theta + offset * 0) * range + range);
  int g = (int)(sin(theta + offset * 1) * range + range);
  int b = (int)(sin(theta + offset * 2) * range + range);
  if(i == 0){ // if you press '0', turn off LED.
    r = 0;
    g = 0;
    b = 0;
  }
  print("r, g, b: ");
  print(r);
  print(", ");
  print(g);
  print(", ");
  print(b);
  println("");
  
  light(r, g, b, unit_id);
  
  // for check
  background(r, g, b);
  
 // change to control
 if(key == 'a'){
   println("pressed key: a");
   for(int k = 0; k < 200; k++)
     myPort.write(0x5f);
 }
 
 // change to auto
 if(key == 'b'){
   println("pressed key: b");
   for(int k = 0; k < 200; k++)
     myPort.write(0x6f);
 }
}
