KatsuhiroMorishita/Wireless-LED-control/program/controler/sonic_hc-sr04_test/sonic_hc-sr04_test.ino

int Trig = 6;
int Echo = 7;
int Duration;
float Distance;

void setup() {
  Serial.begin(9600);
  pinMode(Trig,OUTPUT);
  pinMode(Echo,INPUT);
}

void loop() {
  digitalWrite(Trig,LOW);
  delayMicroseconds(1);
  digitalWrite(Trig,HIGH);
  delayMicroseconds(1);
  digitalWrite(Trig,LOW);
  Duration = pulseIn(Echo,HIGH);
  if (Duration>0) {
    Distance = Duration/2;
    Distance = Distance*340*100/1000000; // ultrasonic speed is 340m/s = 34000cm/s = 0.034cm/us 
    Serial.print(Duration);
    Serial.print(" us ");
    Serial.print(Distance);
    Serial.println(" cm");
  }
  delay(100);
}
