KatsuhiroMorishita/Wireless-LED-control/(commit log)

2014-05-07 初めてのコミット
2014-05-25 v3の追加
    新しいプロトコルに対応したv3を追加しました。v3はIDの書き換えとEEPROMへのバックアップに対応しています。まだ動作テストは実施していませ
    ん。
    [test data.csv, test data.xlsx]
2014-05-29 正式版のプロトコルに対応
    アドレス処理に関するテストを行っていない。なお、リアルタイムでFFTを実施して発色を変化させるサンプルを追加した。
2014-05-30 FFT結果表示におけるバグ修正
    テーブル向けのprocessingスケッチについて、FFTの結果を棒グラフで表示できていなかったバグを修正した。また、電子回路の設計に関するメモ
    を追加している。
2014-05-30 ステージ上のLEDのためのスケッチ開発準備
    ステージ上のLEDを制御するためのスケッチをアップする準備です。電子回路の設計メモや回路モデルの資料も用意し始めました。スケッチはまだダミーです
    。
2014-05-30 字面を揃えた
    数字が並ぶように書き換えた。
2014-05-31 add comment
    コメントを追加
2014-05-31 EEPROMへIDを書き込む際と読み込む際にパリティをチェエクする機能を追加
    Arduinoに対してプログラムを書き込むとEEPROM内に書き込んだ内容がめちゃくちゃになっていたため、EEPROMから読みだしたデータのチェ
    ックを行う機能を追加した。
    実機でのテストは未実施なので注意のこと。
2014-06-02 プロトコル仕様が反映されていない抜けを埋めた
    プロトコルの仕様上はヘッダー以外で8 bit目が1（1000 0000）になることはないのだが、動いてしまった。したがって、そのバグを潰した。
2014-06-02 コメント修正
    コメントを修正した。あと、表示するメッセージも１箇所見なおした。
2014-06-02 新たに作ったバグを修正
    プロトコルを再チェックして、バグを修正しました。
2014-06-05 プロトコルの拡張
    ヘッダのバージョンを増やした。２つのプロトコルをストリーム内で混ぜなければ問題は生じない。
    XBeeとの通信速度を9600 bpsから19200 bpsへ変更した。40個のノードをほぼ10
    fpsで変更することが可能となった。通信速度はもう少し早くしても問題ないかもしれない。それよりも、色味の調整が大変な気がする。
2014-06-05 フォルダとファイル名の変更
    フォルダとファイル名を変更した。なお、v4は崇城大学の和泉先生による改造がなされている。
2014-06-05 コメントの変更
    コメントの変更した。また、ファイル名を再度変更した。ネーミングが悪かったかもしれない。
2014-06-06 高速ソフトシリアルAltSoftSerialへの対応
    高速ソフトシリアルAltSoftSerialへ対応した。これでXBeeとの通信速度19200
    bpsでデータ受信ロスはほぼ心配ないレベルとなった。また、制御用のProcessingサンプルスケッチを作成した。
2014-06-06 コメントを修正
    コメントを修正した。
2014-06-10 USBシリアルの自動検索に対応
    マシンに接続しているUSBシリアルポートが1つであることを前提に、自動的にシリアルポートを選択する機能を追加しました。
2014-06-12 スイッチ用スケッチを追加
    多数のユニットを制御するために、megaを用いたスイッチ制御を行うスケッチを追加した。これで1つのXBee当たりの制御対象LED発光ユニットを最
    大12個まで制御する。
    また、有線で接続されたモジュール様に、そちらは特に気にしない。
2014-06-13 ID割り振り直し
    和泉先生に正式なID割り振りを頂いたので、コード内のID割り振りをやり直した。
2014-06-23 本番時の電子回路や制御プログラムの保存
    2014-06-22時点での状況を保存します。
    [multi_paste.brd, stage_light.brd, stage_light.sch, stage_light_control.brd, stage_light_control.sch, stage_light_paste.brd, table_light_shield.brd, table_light_shield.sch]
2014-06-23 CNC加工情報を追加
    CNCによる基板加工に利用した情報を追加しました。
2014-06-23 電子回路設計情報を整理
    見やすく整理しました。
    [multi_paste.brd, stage_light.brd, stage_light.sch, stage_light_control.brd, stage_light_control.sch, stage_light_paste.brd, table_light_shield.brd, table_light_shield.sch]
2014-06-23 ステージ動作用のプログラムの説明を追加
    ステージ用のプログラムの動作条件等を追記しました。
2014-06-28 ステージ用のテープLED制御に対する様々な対応
    テストコードの追加や、配色配線への対応などを実施しました。内臓RC8
    MHzを利用するユーズ設定も加えています。また、通信路がうまく働くことを確認するために利用したPythonスクリプトも追加しています。
2015-04-29 プログラムの整理
    新しいモジュール用のコードも追加した。Type01に関してはなぜかバグっていたので修正した。
    [test data.csv, test data.xlsx]
2015-04-30 type3用のサンプルコードをリポジトリに追加
    した
2015-04-30 type3のチラツキが収まらないので試行錯誤
    なんともならない・・・
2015-05-04 試験のために、係数を書き換えた
    indexの範囲などを変更している。
2015-05-04 ファイル名変更
    processingのプログラム名を書き換えた
2015-05-05 type01_firmwareを変更する前にコミット
    type01_firmwareを変更する前にコミットしました。ファイル名の整理や、コードの整理を多分に実施しています。
2015-05-06 自律制御・遠隔操作切り替えの実装
    自律制御・遠隔操作切り替え処理を実装した。また、コメントも見直した。
2015-05-06 processingのコードを整理
    processingのコードを整理して、キー入力での操作を行いやすくした。
2015-05-06 processingのコードを整理して、header2に関して1つにまとめた
    いままで1つのIDを対象としたものやキーボード入力とそうでないので分けていたが、意味が無いので1つにした。
2015-05-06 AD変換してシリアル出力するだけのコードを追加
    光センサをPCに接続するためだけのコード
2015-05-07 超音波センサのコードを追加
    遠隔操作モードへの切り替えが悪い。また、Type01の最新コードだと機能が切り替わっていないような気がする。
2015-09-27 ID書き換えコードの修正＆花畑スクランブル対応
    IDの書き換えが環境によって上手く行ったり行かなかったりする問題を修正した。また、2015-09-23の花畑スクランブルイベント「たまいれ」に向
    けたコードも追加した。
2015-10-05 名前と中身が入れ替わっていたのを修正
    ファイルを整理するときに間違えて名前をあべこべにつけていたらしい。
2015-10-28 温度で色を変えるコントローラーを文化祭で使うことになった
    2014年12月に東京国際フォーラムで使ったプログラムを若干変更して対応した。
2016-02-27 2016-02-28水前寺公園こいあかりマイコン制御スケッチを追加
2016-02-27 コメントを追加した
